micahpinto/stm32-dev-board/Hardware/STM32_model.png

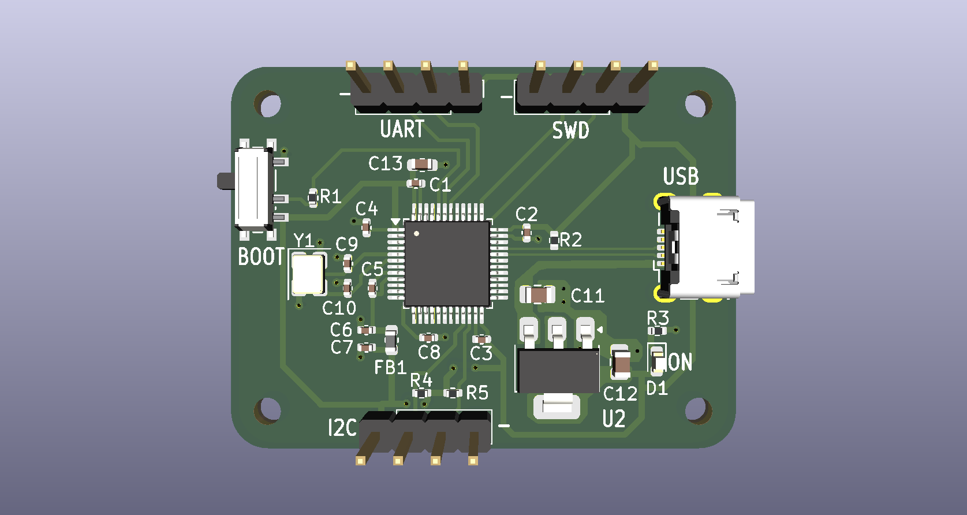
Hardware/STM32_model.png
