micahpinto/stm32-dev-board/images/3d_render.png

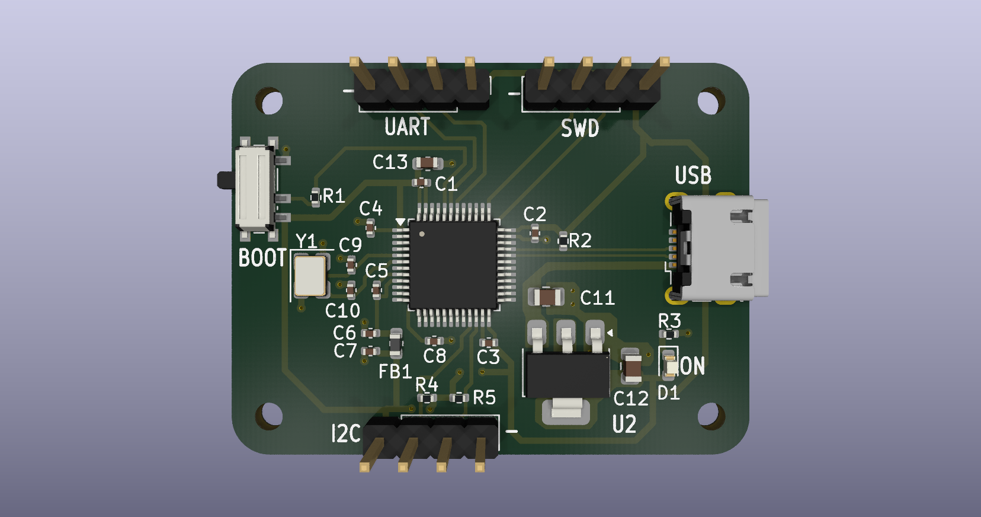
images/3d_render.png
