micahpinto/stm32-dev-board/Fabrication/STM32_schematic.pdf

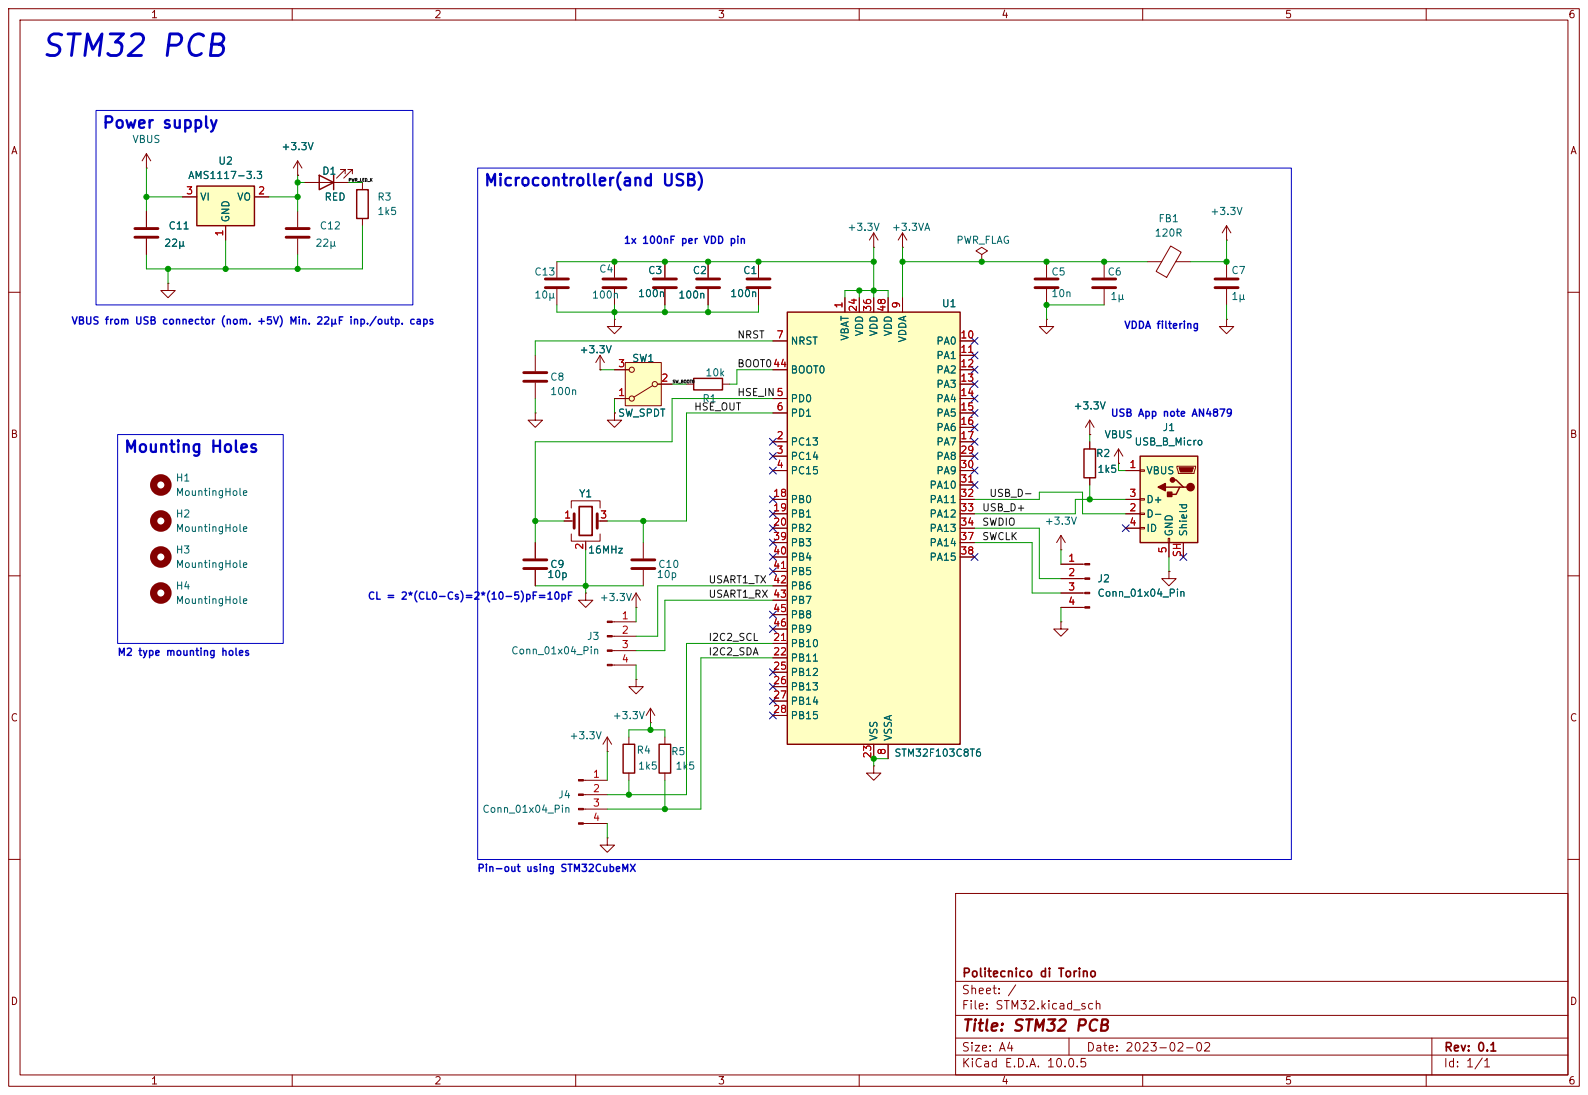
[picture p7: page 1]

VDDA filtering Pin-out using STM32CubeMX STM32 PCB

Size: A4 | Rev: 0.1
KiCad E.D.A. 10.0.5 | Id: 1/1
