micahpinto/stm32-dev-board/Firmware/stm32_pinout/stm32_pinout.ioc

Mcu.UserName=STM32F103C8Tx
PA11.Signal=USB_DM
PA12.Signal=USB_DP
PA13.Signal=SYS_JTMS-SWDIO
PA14.Signal=SYS_JTCK-SWCLK
PB10.Signal=I2C2_SCL
PB11.Signal=I2C2_SDA
PB6.Signal=USART1_TX
PB7.Signal=USART1_RX
PD0-OSC_IN.Signal=RCC_OSC_IN
PD1-OSC_OUT.Signal=RCC_OSC_OUT
